Kiwooky/NHE-Tap-Express/legacy/README.md

# Legacy sketches (2021)

These are the original sketches, unchanged and kept for reference. They need the
[JLed](https://github.com/jandelgado/jled) and [OneButton](https://github.com/mathertel/OneButton) libraries.

| Folder | Date | Notes |
|---|---|---|
| tap-tempo-expression-inputv1.2 | May 2021 | First single-file version |
| tap-tempo-expression-inputv2.0 | May 2021 | Single-file rework |
| Tap-Express_v2.0 / v2.1 | May–Jun 2021 | Split into tabs, Arduino Nano |
| Tap-Express_v3.0 | Jun 2021 | Experimental branch, MIDI stub |
| Tap-Express_v2.2-M5 (+ 3.3v_tap_button) | Jun 2021 | Line6 M5 integration |
| Tap-Express_v2.3-M5-Pro-Mini | Jun 2021 | Pro Mini, board v1.1. Basis for v4. |
