Kiwooky/NHE-Tap-Express/docs/Tap Express M5 board v1.1.pdf

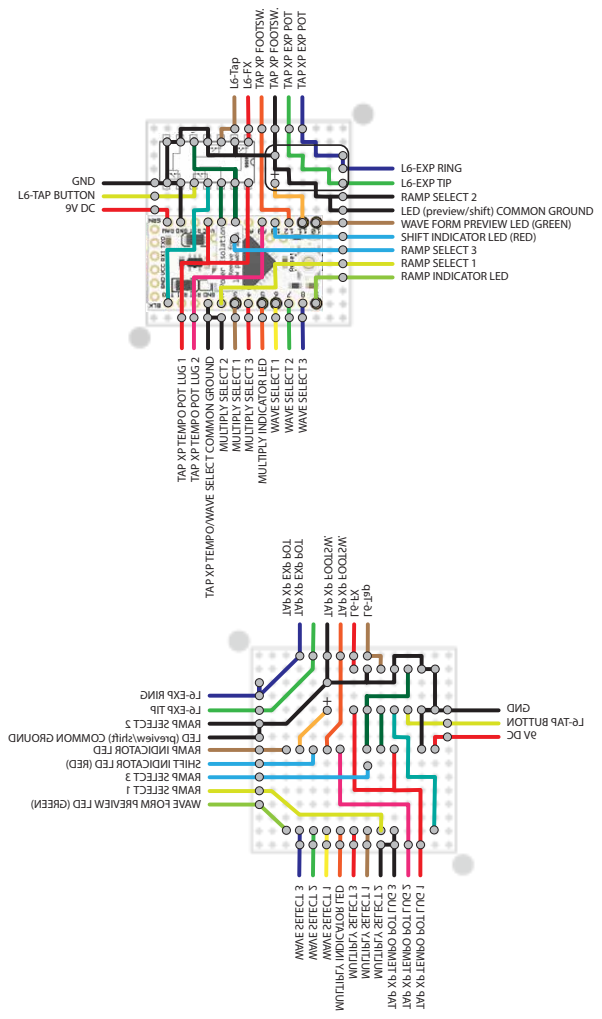
[picture p1: page 1]
L6-Tap L6-FX; L6-TAP BUTTON; WAVE SELECT 3; MULTIPLY SELECT 2; MULTIPLY SELECT 1; MULTIPLY SELECT 3; WAVE SELECT 1; WAVE SELECT 2; GND; L6-Tap

TAP XP FOOTSW.

TAP XP EXP POT

L6-EXP RING
L6-EXP TIP
RAMP SELECT 2
LED (preview/shift) COMMON GROUND
WAVE FORM PREVIEW LED (GREEN)
SHIFT INDICATOR LED (RED)
RAMP SELECT 3
RAMP SELECT 1
RAMP INDICATOR LED

TAP XP TEMPO POT LUG 1

TAP XP TEMPO POT LUG 2

TAP XP TEMPO/WAVE SELECT COMMON GROUND

MULTIPLY INDICATOR LED

TAP XP TEMPO POT LUG 3
